bchess/FPD-LinkIII_Raspberry_HW/fpdlink2raspi/kicad/render_top.png

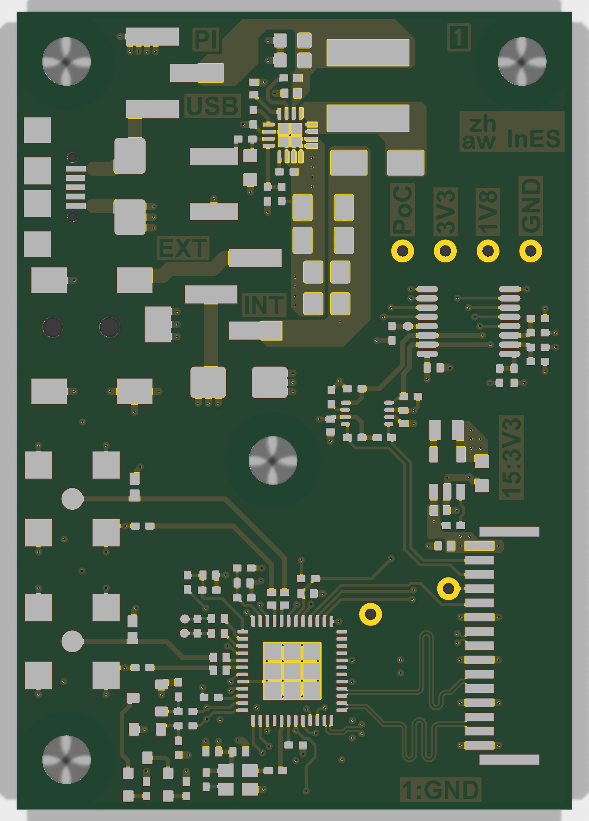
fpdlink2raspi/kicad/render_top.png
