bchess/FPD-LinkIII_Raspberry_HW/fpdlink2raspi/BOM/Bill of Materials-fpdlink2raspi(fpdlink2raspi).xlsx

Name | Description | Designator | Quantity | LibRef | Supplier 1 | Supplier Part Number 1 | Manufacturer 1 | Manufacturer Part Number 1
100n | SMD 100 nF, 50V, X7R, 0402, 10% | C1, C3, C4, C5, C6, C8, C10, C12, C14, C20, C24, C30, C37, C38, C42, C53 | 16 | C0402_100N_X7R_50V_10PCT | Mouser | 81-GCM155R71H104KE2J | Murata | GCM155R71H104KE02J
10n | SMD 10 nF, 16V, X7R, 0402, 10% | C2 | 1 | C0402_010N_X7R_16V_10PCT | Mouser | 81-GRM36X103K16 | Murata | GRM155R71C103KA01D
10u | 10µF, 25V, +/-20%, X5R, 0603 | C7, C9, C11, C13, C23, C29, C51, C52 | 8 | C0603_010U_X5R_25V | Digi-Key | 490-7202-6-ND | Murata | GRM188R61E106MA73D
33n | SMD 33 nF, 50V, X7R, 0402, 10% | C15, C17, C36, C41 | 4 | C0402_033N_X7R_50V_10PCT | Digi-Key | 445-6896-1-ND | TDK | CGA2B3X7R1H333K050BB
15n | SMD 15 nF, 50V, X7R, 0402, 10% | C16, C18 | 2 | C0402_015N_X7R_50V_10PCT | Digi-Key | 445-6894-1-ND | TDK | CGA2B3X7R1H153K050BB
1u | SMD 1 µF, 35V, X5R, 0402, 10% | C19, C27 | 2 | C0402_001U_X5R_35V_10PCT | Digi-Key | 587-6008-1-ND | Taiyo Yuden | GMK105ABJ105KV-F
10n | SMD 10 nF, 50V, X7R, 0402, 10% | C21, C22, C25, C26, C28, C31, C32, C35, C40, C44, C46 | 11 | C0402_010N_X7R_50V_10PCT | Digi-Key | 490-4762-1-ND | Murata | GCM155R71H103KA55D
4u7 | 4.7µF, 25V, +/-10%, X5R, 0603 | C34, C39, C43, C45 | 4 | C0603_04U7_X5R_25V | Digi-Key | 490-7203-1-ND | Murata | GRM188R61E475KE11D
22u | 22µF ±20% 35V Ceramic Capacitor X5R 1206 (3216 Metric) | C47, C48 | 2 | C1206_022U_X5R_35V_20PCT | Digi-Key | 445-8045-1-ND | TDK | C3216X5R1V226M160AC
1u | 1µF ±10% 35V Ceramic Capacitor X7R 0805 (2012 Metric) | C49, C50 | 2 | C0805_001U_X7R_35V_10PCT | Digi-Key | 587-1438-1-ND | Taiyo Yuden | GMK212B7105KG-T
47n | 0.047µF ±10% 16V Ceramic Capacitor X7R 0402 (1005 Metric) | C54 | 1 | C0402_047N_X7R_16V_10PCT | Mouser | 81-GRM155R71C473KA01 | Murata | GRM155R71C473KA01D
15n | 15000pF ±5% 25V Ceramic Capacitor C0G, NP0 0603 (1608 Metric) | C55 | 1 | C0603_15N_C0G_25V_5PCT |  |  | KEMET | C0603C153J3GACTU
1u | 1µF ±10% 50V Ceramic Capacitor X7R 1812 (4532 Metric) | C56 | 1 | C1812_001U_X7R_50V_10PCT | LCSC | C452759 | KEMET | C1812C105K5RACTU
4u7 | SMD 4.7 µF, 10V, X5R, 0402, 20% | C57 | 1 | C0402_04U7_X5R_10V_20PCT | Mouser | 81-GRM155R61A475MEAD | Murata | GRM155R61A475MEAAD
22u | SMD 22 µF, 6.3V, X5R, 0603, 20% | C58 | 1 | C0603_022U_X5R_6V3_20PCT | Digi-Key | 490-13241-1-ND | Murata | GRM186R60J226ME15D
Green, 3.2 V, 140° | WL-SMCD SMD Mono-color Chip LED Diffused, size 0603, Green, 3.2 V, 140° | D1 | 1 | D_WE_150060GS55040 | Mouser | 710-150060GS55040 | Wurth Electronics | 150060GS55040
Yellow, 2 V, 140° | WL-SMCD SMD Mono-color Chip LED Diffused, size 0603, Yellow, 2 V, 140° | D2 | 1 | D_WE_150060YS55040 | Mouser | 710-150060YS55040 | Wurth Electronics | 150060YS55040
SMBJ5.0A | 9.2V Clamp 65.2A Ipp Tvs Diode Surface Mount DO-214AA (SMBJ) | D3 | 1 | D_TVS_5V0_Power | Digi-Key | SMBJ5.0A-E3/52GICT-ND | Vishay Semiconductors | SMBJ5.0A-E3/52
B340LA-13-F | Diode Schottky 40V 3A Surface Mount SMA | D4 | 1 | D_DIODES_B340LA-13-F | Digi-Key | B340LA-FDICT-ND | Diodes | B340LA-13-F
SMBJ24A | 38.9V Clamp 15.5A Ipp Tvs Diode Surface Mount DO-214AA (SMBJ) | D5 | 1 | D_TVS_24V | Digi-Key | SMBJ24ALFCT-ND | Littelfuse | SMBJ24A
SFW15R-1ST | 15 Position FFC, FPC Connector Contacts, Bottom 0.039" (1.00mm) Surface Mount, Right Angle | J1 | 1 | J_PI_CAMV2_BOTTOM | Mouser | 649-SFW15R-1STE1LF | Amphenol ICC | SFW15R-1STE1LF
PJ-075DH-SMT-TR | 1.3 x 3.7 mm, 3.5 A, Horizontal, Surface Mount _SMT_, Shielded, Dc Power Jack Connector | J2 | 1 | J_CUI_PJ-075CH-SMT-TR | Mouser | 490-PJ-075DH-SMT-TR | Same Sky (formerly CUI Devices) | PJ-075DH-SMT-TR
Micro USB | WR-COM Micro USB SMT Type B | J3 | 1 | J_WE_629105136821 | Digi-Key | 732-3155-1-ND | Wurth Electronics | 629105136821
10u | LQH3NPZ100MJR SMD Shielded coil, 10 µH, 0.81 A, 0.24 Ω, 30 MHz | L1, L5 | 2 | L1212_SHCOIL_10U_0A81_0R24_20PCT | Arrow | LQH3NPZ100MJRL | Murata | LQH3NPZ100MJRL
1k 0.4A 0.5R | BLM18AG102SN1D SMD Ferrite Bead 1kΩ@100MHz, 25%, 0.4A, DC 500mΩ | L2, L6 | 2 | L0603_BEAD_001K_0A4_25PCT | Mouser | 81-BLM11A102S | Murata | BLM18AG102SN1D
330R 0.7A 280mR | MPZ1005S331ETD25 SMD Ferrite Bead 330Ω@100MHz ±25%, 700 mA, DC 280 mΩ | L3, L7 | 2 | L0402_BEAD_330R_0A7_25PCT | Mouser | 810-MPZ1005S331ETD25 | TDK | MPZ1005S331ETD25
47R 0.45A 450mR | MPZ1005F470ETD25 SMD Ferrite Bead 47Ω@100MHz ±25%, 450 mA, DC 450 mΩ | L4, L8 | 2 | L0402_BEAD_047R_0A45_25PCT | Mouser | 810-MPZ1005F470ETD25 | TDK | MPZ1005F470ETD25
120R 3A 25mR | BLM18SG121TN1D SMD Ferrite Bead 120Ω@100MHz, 25%, 3A, DC 25mΩ | L9, L10, L11, L12 | 4 | L0603_BEAD_120R_3A_25PCT | Mouser | 81-BLM18SG121TN1D | Murata | BLM18SG121TN1D
12uH, 2.6A | WE-LQS SMT Power Inductor, size 6045, 12uH, 2.6A | L13 | 1 | L_WE_74404064120 | Digi-Key | 732-5551-1-ND | Wurth Electronics | 74404064120
2u2 | DFE201210U-2R2M=P2 SMD Shielded coil, 2.2 µH ±20%, 1.2 A, 0.228 Ω | L14 | 1 | L0805_SHCOIL_2U2_1A2_R228_20PCT | Mouser | 81-DFE201612E-2R2MP2 | Murata | DFE201612E-2R2M=P2
QPC02SXGN-RC | 2 (1 x 2) Position Shunt Connector Black Open Top 0.100" (2.54mm) Gold | M1, M2 | 2 | M_JUMPER_2.54 | Digi-Key | S9337-ND | Sullins | QPC02SXGN-RC
BSS138-13-F | N-Channel Digital FET 50V, 0.2A, 3.5Ω | Q1, Q2 | 2 | Q_DIODES_BSS138-13-F | Mouser | 621-BSS138-13-F | Diodes | BSS138-13-F
0R | SMD 0 Ω, 0402, 1.5 A, 20 mΩ Rmax | R1, R18, R19, R26, R35, R36, R37, R41, R43 | 9 | R0402_000R_1A5_0R02 | Mouser | 71-CRCW0402-0-E3 | Vishay | CRCW04020000Z0ED
10k | SMD 10 kΩ, 1%, 50V, 0402, 1/16W, ±100ppm | R2, R3, R32, R42 | 4 | R0402_010K_50V_0W063_100PPM | Mouser | 71-CRCW0402-10K-E3 | Vishay | CRCW040210K0FKED
1k | SMD 1 kΩ, 0.1%, 50V, 0402, 1/16W, ±25ppm | R7, R8, R9 | 3 | R0402_001K_50V_0W063_25PPM_0PCT1 | Digi-Key | P1.0KDCCT-ND | Panasonic | ERA-2AEB102X
4k7 | SMD 4.7 kΩ, 1%, 50V, 0402, 1/16W, ±100ppm | R10, R11, R25 | 3 | R0402_04K7_50V_0W063_100PPM | Digi-Key | 541-4.70KLCT-ND | Vishay | CRCW04024K70FKED
47k | SMD 47 kΩ, 1%, 50V, 0402, 1/16W, ±100ppm | R12, R13, R33, R34 | 4 | R0402_047K_50V_0W063_100PPM | Mouser | 71-CRCW0402-47K-E3 | Vishay | CRCW040247K0FKED
1k | SMD 1 kΩ, 0.1%, 50V, 0402, 1/16W, ±25ppm | R14 | 1 | R0402_001K_50V_0W063_100PPM | Digi-Key | 541-1.00KLDKR-ND | Vishay Dale | CRCW04021K00FKED
1k2 | SMD 1.2 kΩ, 1%, 50V, 0402, 1/16W, ±100ppm | R15 | 1 | R0402_01K2_50V_0W063_100PPM | Digi-Key | 541-1.20KLCT-ND | Vishay | CRCW04021K20FKED
390R | SMD 390 Ω, 1%, 50V, 0402, 1/16W, ±100ppm | R16 | 1 | R0402_390R_50V_0W063_100PPM | Digi-Key | 541-390LCT-ND | Vishay | CRCW0402390RFKED
4k02 | SMD 4.02 kΩ, 1%, 75V, 0603, 1/10W, ±100ppm | R17, R22 | 2 | R0603_4K02_75V_0W100_100PPM | Digi-Key | 541-4.02KHCT-ND | Vishay | CRCW06034K02FKEA
118k | SMD 118 kΩ, 1%, 50V, 0402, 1/16W, ±100ppm | R20, R21 | 2 | R0402_118K_50V_0W063_100PPM | Digi-Key | 541-118KLCT-ND | Vishay | CRCW0402118KFKED
49R9 | SMD 49.9 Ω, 1%, 50V, 0402, 1/16W, ±100ppm | R23, R24 | 2 | R0402_49R9_50V_0W063_100PPM | Mouser | 71-CRCW0402-49.9-E3 | Vishay | CRCW040249R9FKED
78k7 | SMD 78.7 kΩ, 1%, 50V, 0402, 1/16W, ±100ppm | R28 | 1 | R0402_78K7_50V_0W063_100PPM | Digi-Key | 541-78.7KLCT-ND | Vishay | CRCW040278K7FKED
100R | SMD 100 Ω, 1%, 50V, 0402, 1/16W, ±100ppm | R30 | 1 | R0402_100R_50V_0W063_100PPM | Digi-Key | 541-100LCT-ND | Vishay Dale | CRCW0402100RFKED
97k6 | SMD 97.6 kΩ, 1%, 50V, 0402, 1/16W, ±100ppm | R31 | 1 | R0402_97K6_50V_0W063_100PPM | Mouser | 71-CRCW0402-97.6K-E3 | Vishay | CRCW040297K6FKED
63k4 | SMD 63.4 kΩ, 1%, 50V, 0402, 1/16W, ±100ppm | R38 | 1 | R0402_63K4_50V_0W063_100PPM | Mouser | 71-CRCW0402-63.4K-E3 | Vishay | CRCW040263K4FKED
390R | SMD 390 Ω, 1%, 50V, 0402, 1/16W, ±100ppm | R39 | 1 | R0402_390R_50V_0W063_100PPM | Digi-Key | 541-390LCT-ND | Vishay | CRCW0402390RFKED
60k4 | 60.4 kOhms ±1% 0.063W, 1/16W Chip Resistor 0402 (1005 Metric) Automotive AEC-Q200 Thick Film | R40 | 1 | R0402_60K4_50V_0W063_100PPM | Digi-Key | 541-60.4KLCT-ND | Vishay | CRCW040260K4FKED
TCA9534APW | TCA9534A Low Voltage 8-Bit I2C and SMBUS Low-Power I/O Expander With Interrupt Output and Configuration Registers | U1 | 1 | U_TI_TCA9534APW | Digi-Key | 296-40573-1-ND | Texas Instruments | TCA9534APWR
TCA9406DCUR | TCA9406 Dual Bidirectional 1-MHz I2C-BUS and SMBus Voltage Level-Translator, 1.65 to 3.6 V, -40 to 85 degC, 8-pin US8 (DCU), Green (RoHS & no Sb/Br) | U2 | 1 | U_TI_TCA9406DCUR | Digi-Key | 296-28109-6-ND | Texas Instruments | TCA9406DCUR
DS90UB954TRGZxQ1 | DS90UB954-Q1 Dual 4.16 Gbps FPD-Link III Deserializer Hub With MIPI CSI-2 Outputs for 2MP/60fps Cameras and RADAR | U3 | 1 | U_TI_DS90UB954-Q1 | Digi-Key | 296-48292-1-ND | Texas Instruments | DS90UB954TRGZRQ1
TPS55340RTE | Integrated 5-A Wide Input Range Boost/SEPIC/Flyback DC/DC Regulator | U4 | 1 | U_TI_TPS55340RTE | Digi-Key | 296-30530-1-ND | Texas Instruments | TPS55340RTET
LM3671MFX-1.8/NOPB | LM3671/-Q1 2-MHz, 600-mA Step-Down DC-DC Converter | U5 | 1 | U_TI_LM3671MFX-1.8 | Digi-Key | 296-41425-1-ND | TI National Semiconductor | LM3671MFX-1.8/NOPB
SMA JACK STR | SMA Connector Jack, Female Socket 50Ohm Surface Mount Solder (PN: 0732511350) | X1, X2 | 2 | X_MOLEX_0732511350 | Mouser | 538-73251-1350 | Molex | 73251-1350
1241150-3 | Connector Header Through Hole 3 position 0.100" (2.54mm) | X3, X4 | 2 | J_3x1_2.54mm_header_SMD | Mouser | 571-1241150-3 | AMP - TE CONNECTIVITY | 1241150-3
SG-210STF 25.0000M | Crystal Oscillator 25 MHz, ±50 ppm | Y1 | 1 | Y_SG-210STF25.0000M | Mouser | 732-SG210STF25.Y3 | Epson | SG-210STF 25.0000MY3
