bchess/FPD-LinkIII_Raspberry_HW/fpdlink2raspi/kicad/fpdlink2raspi.kicad_pcb

## KiCad design fpdlink2raspi/kicad/fpdlink2raspi.kicad_pcb (2026-11-09)

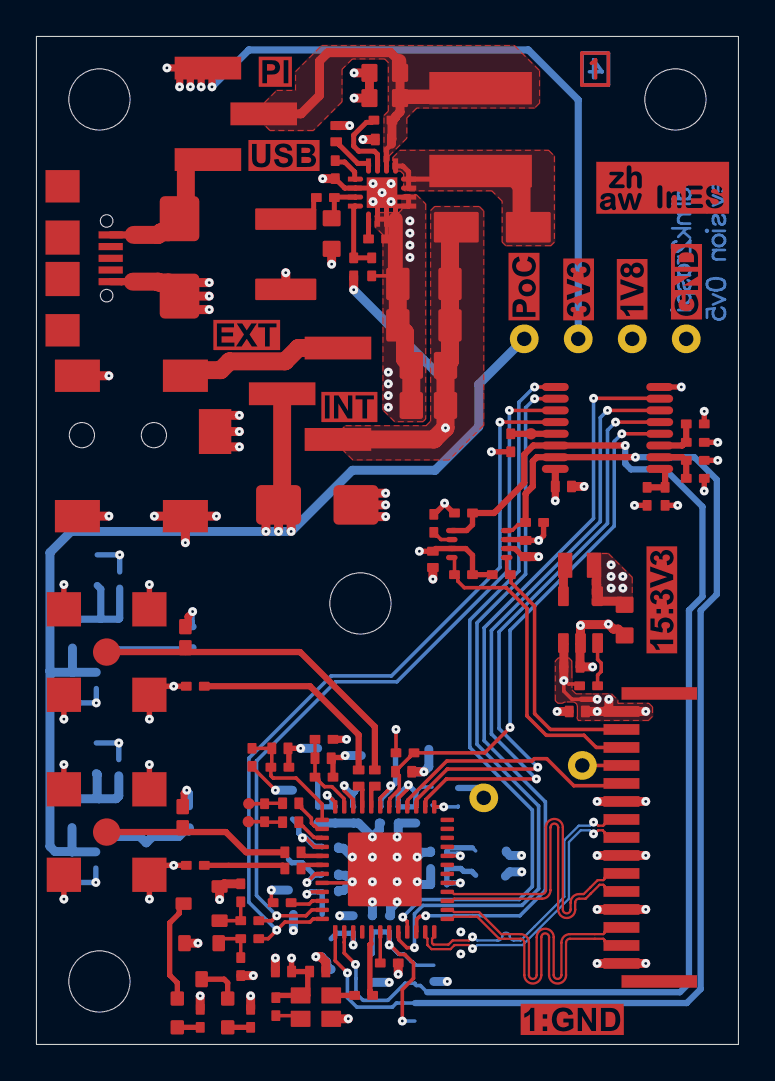
[picture p2: board fpdlink2raspi.kicad_pcb from above]

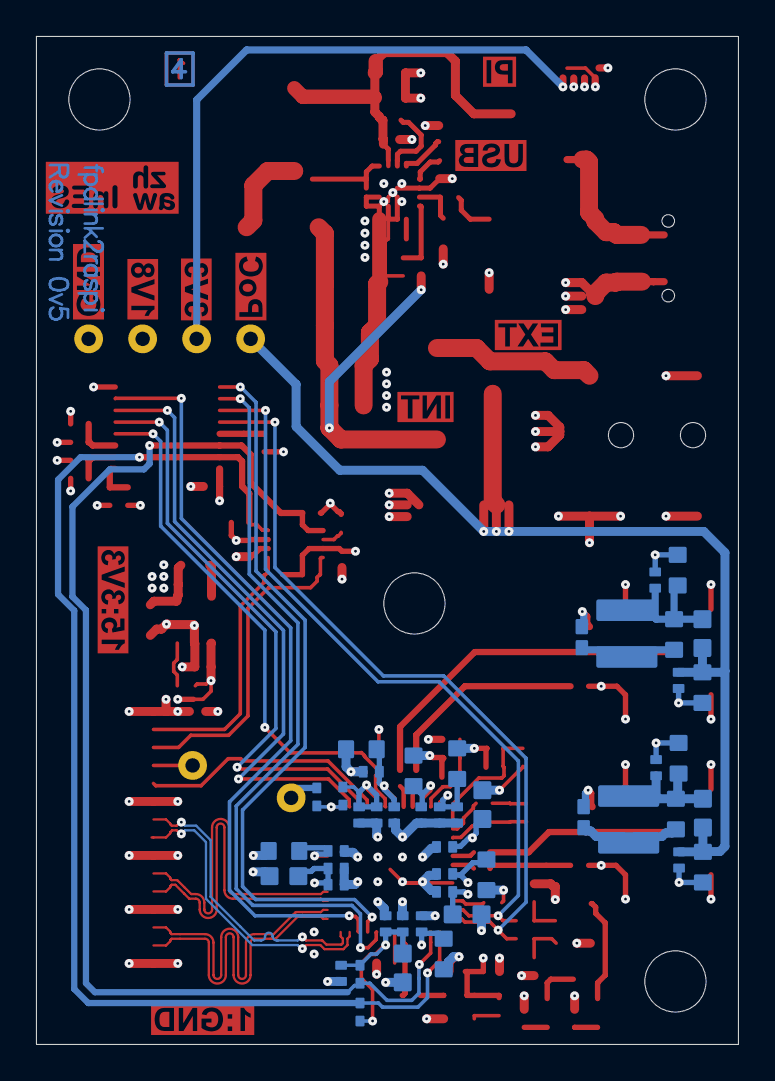
[picture p3: board fpdlink2raspi.kicad_pcb from below]

Board: 4 copper layers, 39.0 x 56.0 mm, 148 parts (47 on the bottom side), 84 nets.

Parts:
C1, C3, C4, C5, C6, C8, C10, C12, C14, C20, C24, C30, C37, C38, C42, C53: 100n; C_0402_1005Metric
C2, C21, C22, C25, C26, C28, C31, C32, C35, C40, C44, C46: 10n; C_0402_1005Metric
C7, C9, C11, C13, C23, C29, C51, C52: 10u; C_0603_1608Metric
C15, C17, C36, C41: 33n; C_0402_1005Metric
C16, C18: 15n; C_0402_1005Metric
C19, C27: 1u; C_0402_1005Metric
C33, C57: 4u7; C_0402_1005Metric
C34, C39, C43, C45: 4u7; C_0603_1608Metric
C47, C48: 22u; C_1206_3216Metric
C49, C50: 1u; C_0805_2012Metric
C54: 47n; C_0402_1005Metric
C55: 15n; C_0603_1608Metric
C56: 1u; C_1812_4532Metric
C58: 22u; C_0603_1608Metric
D1: Green, 3.2 V, 140°; LED_0603_1608Metric
D2: Yellow, 2 V, 140°; LED_0603_1608Metric
D3: SMBJ5.0A; D_SMB
D4: B340LA-13-F; D_SMA
D5: SMBJ24A; D_SMB
J1: SFW15R-1ST; Amphenol_SFW15R-1STE1LF_1x15_P1.00mm_Horizontal
J2: PJ-075DH-SMT-TR; CUI_PJ-075CH-SMT_DC_Jack
J3: Micro USB; Wurth_629105136821_USB_Micro-B
L1, L5: 10u; L_Murata_LQH3NP_3.0x3.0mm
L2, L6: 1k 0.4A 0.5R; L_0603_1608Metric
L3, L7: 330R 0.7A 280mR; L_0402_1005Metric
L4, L8: 47R 0.45A 450mR; L_0402_1005Metric
L9, L10, L11, L12: 120R 3A 25mR; L_0603_1608Metric
L13: 12uH, 2.6A; L_Wurth_WE-LQS-6045
L14: 2u2; L_Murata_DFE201612E
MH1, MH2, MH3, MH4: MountingHole; MountingHole_3.4mm_NPTH
Q1, Q2: BSS138-13-F; SOT-23
R1, R18, R19, R26, R35, R36, R37, R41, R43: 0R; R_0402_1005Metric
R2, R3, R29, R32, R42: 10k; R_0402_1005Metric
R4, R5, R6, R7, R8, R9, R14: 1k; R_0402_1005Metric
R10, R11, R25, R27: 4k7; R_0402_1005Metric
R12, R13, R33, R34: 47k; R_0402_1005Metric
R15: 1k2; R_0402_1005Metric
R16, R39: 390R; R_0402_1005Metric
R17, R22: 4k02; R_0603_1608Metric
R20, R21: 118k; R_0402_1005Metric
R23, R24: 49R9; R_0402_1005Metric
R28: 78k7; R_0402_1005Metric
R30: 100R; R_0402_1005Metric
R31: 97k6; R_0402_1005Metric
R38: 63k4; R_0402_1005Metric
R40: 60k4; R_0402_1005Metric
TP1: 0v1 27.04.20 gana Review release.; TestPoint_THTPad_D1.6mm_Drill0.8mm
TP2: PIC301; TestPoint_Pad_D0.635mm
TP3: A0; TestPoint_THTPad_D1.6mm_Drill0.8mm
TP4, TP5: TestPoint; TestPoint_Pad_D0.635mm
TP6, TP7, TP9: TestPoint; TestPoint_THTPad_D1.6mm_Drill0.8mm
TP8: 2 MHz (1.6 - 2.6 MHz); TestPoint_THTPad_D1.6mm_Drill0.8mm
U1: TCA9534APW; TSSOP-16_4.4x5mm_P0.65mm
U2: TCA9406DCUR; TI_US8_DCU_2.3x2.0mm_P0.5mm
U3: DS90UB954TRGZxQ1; VQFN-48-1EP_7x7mm_P0.5mm_EP4.1x4.1mm
U4: TPS55340RTE; WQFN-16-1EP_3x3mm_P0.5mm_EP1.7x1.7mm
U5: LM3671MFX-1.8/NOPB; SOT-23-5
X1, X2: SMA JACK STR; Molex_73251-1350_SMA_Vertical
X3, X4: 1241150-3; TE_1241150-3_1x03_P2.54mm_SMD
Y1: SG-210STF 25.0000M; Oscillator_Epson_SG-210STF_2.5x2.0mm

Connections:
1V8: C1.2, C2.2, C3.2, C6.2, C58.2, L9.1, L10.1, L11.1, L12.1, L14.2, R2.1, R3.2, R4.2, R5.2, R6.2, R10.2, R11.2, R14.1, R27.2, R28.2, R29.2, TP9.1, U1.16, U2.3, U5.4, Y1.4
3V3: C4.2, C5.2, C57.2, J1.15, R12.2, R13.2, R15.2, R16.2, R43.1, TP6.1, U2.7, U5.1, X3.3
D_CLK_0_N: J1.8, U3.11
D_CLK_0_P: J1.9, U3.12
D_DATA_0_N: J1.2, U3.13
D_DATA_0_P: J1.3, U3.14
D_DATA_1_N: J1.5, U3.15
D_DATA_1_P: J1.6, U3.16
GND: C1.1, C2.1, C3.1, C4.1, C5.1, C6.1, C7.1, C8.1, C9.1, C10.1, C11.1, C12.1, C13.1, C14.1, C19.1, C20.1, C21.1, C22.1, C23.1, C24.1, C25.1, C26.1, C27.1, C28.1, C29.1, C30.1, C31.1, C32.1, C33.1, C34.1, C35.1, C37.1, C38.1, C39.1, C40.1, C42.1, C43.1, C44.1, C45.1, C46.1, C47.2, C48.2, C49.2, C50.1, C51.1, C52.1, C53.1, C54.1, C55.1, C56.1, C57.1, C58.1, D3.2, D5.2, J1.1, J1.4, J1.7, J1.10, J2.2, J2.3, J2.4, J2.5, J3.5, Q1.2, Q2.2, R7.1, R8.1, R9.1, R20.1, R21.1, R23.1, R24.1, R31.1, R32.1, R35.1, R36.1, R40.1, R41.1, R42.1, TP8.1, U1.8, U2.2, U3.44, U3.49, U4.6, U4.10, U4.11, U4.12, U4.13, U4.14, U4.17, U5.2, X1.2, X1.3, X1.4, X1.5, X2.2, X2.3, X2.4, X2.5, Y1.2
IDX: C38.2, R29.1, R32.2, U3.35
MODE: C37.2, R28.1, R31.2, U3.37
NetC9_2: C9.2, C10.2, L1.1, L2.2, R17.1
NetC13_2: C13.2, C14.2, L5.1, L6.2, R22.1
NetC15_1: C15.1, U3.41
NetC15_2: C15.2, L4.2, X1.1
NetC16_1: C16.1, R23.2
NetC16_2: C16.2, U3.42
NetC17_1: C17.1, U3.32
NetC17_2: C17.2, L8.2, X2.1
NetC18_1: C18.1, R24.2
NetC18_2: C18.2, U3.33
NetC23_2: C23.2, C24.2, C25.2, C26.2, L10.2, U3.36, U3.45
NetC27_2: C27.2, C28.2, L11.2, U3.17
NetC29_2: C29.2, C30.2, C31.2, C32.2, L12.2, U3.31, U3.40
NetC33_2: C33.2, R27.1, U1.4, U3.30
NetC34_2: C34.2, C35.2, U3.3
NetC36_1: C36.1, R30.2, TP4.1
NetC36_2: C36.2, U3.38
NetC39_2: C39.2, C40.2, U3.20
NetC41_1: C41.1, R30.1, TP5.1
NetC41_2: C41.2, U3.39
NetC43_2: C43.2, C44.2, U3.43
NetC45_2: C45.2, C46.2, U3.34
NetC47_1: C47.1, C48.1, C49.1, C50.2, D4.1, R38.2, X4.3
NetC51_2: C51.2, C52.2, C53.2, L13.1, R37.1, U4.2, X3.2
NetC54_2: C54.2, U4.4
NetC55_2: C55.2, R39.1, U4.7
NetC56_2: C56.2, R39.2
NetD1_1: D1.1, Q1.3
NetD1_2: D1.2, R15.1
NetD2_1: D2.1, Q2.3
NetD2_2: D2.2, R16.1
NetD3_1: D3.1, J3.1, X3.1
NetD4_2: D4.2, L13.2, U4.1, U4.15, U4.16
NetJ1_11: J1.11, U3.28
NetJ1_12: J1.12, TP3.1
NetJ1_13: J1.13, R12.1, U2.8
NetJ1_14: J1.14, R13.1, U2.1
NetJ2_1: J2.1, X4.1
NetL1_2: L1.2, L3.1, R17.2
NetL3_2: L3.2, L4.1
NetL5_2: L5.2, L7.1, R22.2
NetL7_2: L7.2, L8.1
NetL14_1: L14.1, U5.5
NetQ1_1: Q1.1, R18.2, R20.2
NetQ2_1: Q2.1, R19.2, R21.2
NetR1_1: R1.1, Y1.3
NetR2_2: R2.2, Y1.1
NetR3_1: R3.1, TP2.1, U1.13
NetR4_1: R4.1, R7.2, U1.1
NetR5_1: R5.1, R8.2, U1.2
NetR6_1: R6.1, R9.2, U1.3
NetR10_1: R10.1, R33.1, U1.15, U2.4, U3.1
NetR11_1: R11.1, R34.1, U1.14, U2.5, U3.2
NetR14_2: R14.2, U2.6
NetR25_1: R25.1, R26.2, U3.25
NetR35_2: R35.2, U3.6
NetR36_2: R36.2, U3.46
NetR37_2: R37.2, U4.3
NetR38_1: R38.1, R42.2, U4.8
NetR40_2: R40.2, U4.9
NetR41_2: R41.2, U4.5
NetR43_2: R43.2, U5.3
NetTP1_1: R26.1, TP1.1
NetU1_5: U1.5, U3.27
NetU1_6: U1.6, U3.26
NetU1_7: U1.7, U3.10
NetU1_9: U1.9, U3.9
NetU3_8: U1.10, U3.8
REF_CLK: R1.2, U3.5
TI_LOCK: R19.1, U1.12, U3.48
TI_PASS: R18.1, U1.11, U3.47
VDDIO: C19.2, C20.2, C21.2, C22.2, C42.2, L9.2, R25.2, R33.2, R34.2, U3.7, U3.29
V_POC: C7.2, C8.2, C11.2, C12.2, D5.1, L2.1, L6.1, TP7.1, X4.2
