bchess/FPD-LinkIII_Raspberry_HW/(commit log)

2026-11-09 Modify components for TPS55340 to output 9V instead of 24V. Also replace discontinued PJ-075CH-SMT-TR with PJ-075DH-SMT-TR
    [Bill of Materials-fpdlink2raspi(fpdlink2raspi).xlsx]
2026-11-09 reverse-engineered kicad source
    [fpdlink2raspi.kicad_pcb]
